subterra-robotics/Subterra-Rover/CAD Models/Chasis Base - Print Parts/03_SecB_negX_outer-face-down.stl

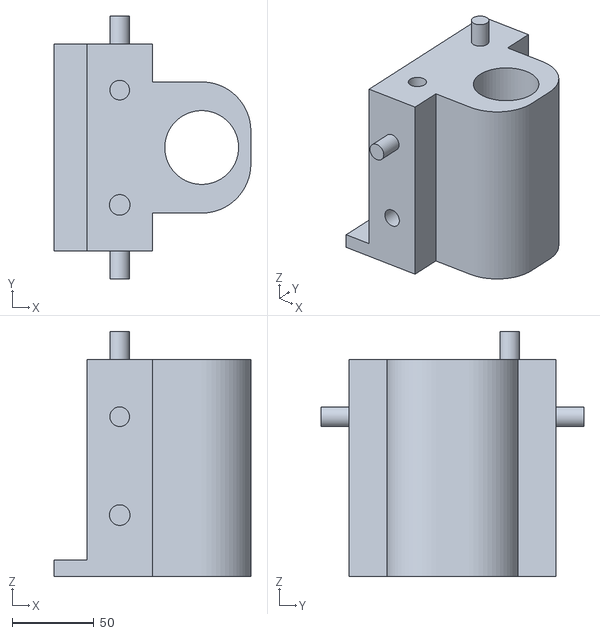
[picture p1: CAD file, 2026-11-07]
CAD Models/Chasis Base - Print Parts/03_SecB_negX_outer-face-down.stl
120.0 x 160.4 x 149.5
