subterra-robotics/Subterra-Rover/CAD Models/Chasis Base - Print Parts/01_SecA_negX_floor-down.stl

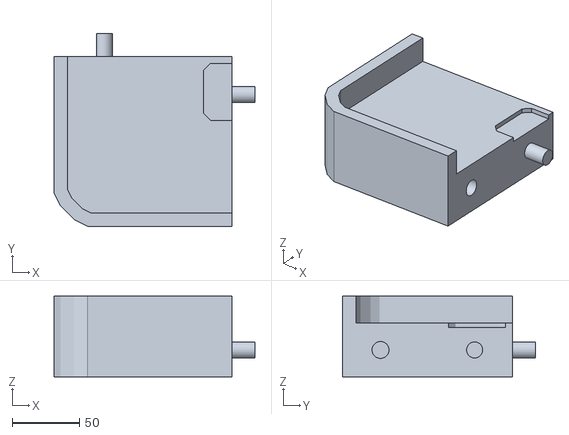
[picture p2: CAD file, 2026-11-07]
CAD Models/Chasis Base - Print Parts/01_SecA_negX_floor-down.stl
149.5 x 143.4 x 60.0
