subterra-robotics/Subterra-Rover/CAD Models/Chasis Base - Print Parts/02_SecA_posX_floor-down.stl

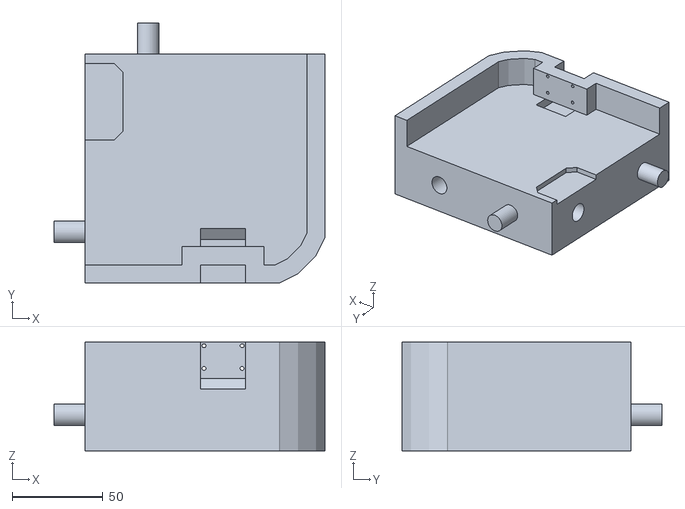
[picture p3: CAD file, 2026-11-07]
CAD Models/Chasis Base - Print Parts/02_SecA_posX_floor-down.stl
149.5 x 143.4 x 60.0
