subterra-robotics/Subterra-Rover/(list of files, cad)

Other CAD files:
CAD Models/Chasis Base - Print Parts/05_SecC_negX_floor-down.stl
CAD Models/Chasis Base - Print Parts/04_SecB_posX_outer-face-down.stl
CAD Models/Chasis Base - Print Parts/06_SecC_posX_floor-down.stl
CAD Models/Eye Casing - 10-5-2026.f3d
CAD Models/Eye Casing.f3d
