subterra-robotics/Subterra-Rover/docs/Testing data.docx

## Wifi Testing

No blockage
1 meter

03:09:12 CONNECTED signal= -- ping= 147 ms loss= 0%

03:09:13 CONNECTED signal= -- ping= 65 ms loss= 0%

03:09:14 CONNECTED signal= -- ping= 3 ms loss= 0%

03:09:15 CONNECTED signal= -- ping= 10 ms loss= 0%

03:09:16 CONNECTED signal= -- ping= 3 ms loss= 0%

03:09:17 CONNECTED signal= -- ping= 2 ms loss= 0%

03:09:18 CONNECTED signal= -- ping= 8 ms loss= 0%

03:09:19 CONNECTED signal= -- ping= 17 ms loss= 0%

03:09:20 CONNECTED signal= -- ping= 29 ms loss= 0%

03:09:21 CONNECTED signal= -- ping= 124 ms loss= 0%

5 meters

03:09:28 CONNECTED signal= -- ping= 2 ms loss= 0%

03:09:29 CONNECTED signal= -- ping= 138 ms loss= 0%

03:09:30 CONNECTED signal= -- ping= 168 ms loss= 0%

03:09:31 CONNECTED signal= -- ping= 20 ms loss= 0%

03:09:32 CONNECTED signal= -- ping= 201 ms loss= 0%

03:09:33 CONNECTED signal= -- ping= 27 ms loss= 0%

03:09:34 CONNECTED signal= -- ping= 2 ms loss= 0%

03:09:35 CONNECTED signal= -- ping= 71 ms loss= 0%

03:09:36 CONNECTED signal= -- ping= 105 ms loss= 0%

03:09:37 CONNECTED signal= -- ping= 5 ms loss= 0%

10 meters

03:09:46 CONNECTED signal= -- ping= 89 ms loss= 10%

03:09:47 CONNECTED signal= -- ping= 118 ms loss= 10%

03:09:48 CONNECTED signal= -- ping= 147 ms loss= 10%

03:09:49 CONNECTED signal= -- ping= 72 ms loss= 10%

03:09:50 CONNECTED signal= -- ping= 96 ms loss= 10%

03:09:51 CONNECTED signal= -- ping= 22 ms loss= 10%

03:09:52 CONNECTED signal= -- ping= 3 ms loss= 10%

03:09:53 CONNECTED signal= -- ping= 167 ms loss= 10%

03:09:54 CONNECTED signal= -- ping= 79 ms loss= 0%

03:09:55 CONNECTED signal= -- ping= 3 ms loss= 0%

20 meters

03:10:06 CONNECTED signal= -- ping= lost loss= 10%

03:10:06 CONNECTED signal= -- ping= 133 ms loss= 10%

03:10:07 CONNECTED signal= -- ping= 110 ms loss= 10%

03:10:08 CONNECTED signal= -- ping= 194 ms loss= 10%

03:10:09 CONNECTED signal= -- ping= 171 ms loss= 10%

03:10:10 CONNECTED signal= -- ping= 233 ms loss= 10%

03:10:11 CONNECTED signal= -- ping= 83 ms loss= 10%

03:10:12 CONNECTED signal= -- ping= 107 ms loss= 10%

03:10:13 CONNECTED signal= -- ping= 164 ms loss= 10%

03:10:14 CONNECTED signal= -- ping= 103 ms loss= 10%

03:10:15 CONNECTED signal= -- ping= 24 ms loss= 0%

Walking further away starting from 20 meters, ending bout 50 meters

03:10:17 CONNECTED signal= -- ping= lost loss= 10%

03:10:17 CONNECTED signal= -- ping= 2 ms loss= 10%

03:10:18 CONNECTED signal= -- ping= 2 ms loss= 10%

03:10:20 CONNECTED signal= -- ping= lost loss= 20%

03:10:20 CONNECTED signal= -- ping= 99 ms loss= 20%

03:10:22 CONNECTED signal= -- ping= lost loss= 30%

03:10:22 CONNECTED signal= -- ping= 170 ms loss= 30%

03:10:24 CONNECTED signal= -- ping= lost loss= 40%

03:10:24 CONNECTED signal= -- ping= 6 ms loss= 40%

03:10:25 CONNECTED signal= -- ping= 13 ms loss= 40%

03:10:26 CONNECTED signal= -- ping= 241 ms loss= 30%

03:10:28 CONNECTED signal= -- ping= lost loss= 40%

03:10:29 CONNECTED signal= -- ping= lost loss= 50%

03:10:30 CONNECTED signal= -- ping= lost loss= 50%

03:10:31 CONNECTED signal= -- ping= 951 ms loss= 50%

03:10:32 CONNECTED signal= -- ping= lost loss= 50%

03:10:33 CONNECTED signal= -- ping= 952 ms loss= 50%

03:10:34 CONNECTED signal= -- ping= lost loss= 50%

03:10:35 CONNECTED signal= -- ping= lost loss= 60%

03:10:36 CONNECTED signal= -- ping= lost loss= 70%

03:10:36 CONNECTED signal= -- ping= 144 ms loss= 70%
