subterra-robotics/Subterra-Rover/Schematic V1.pdf

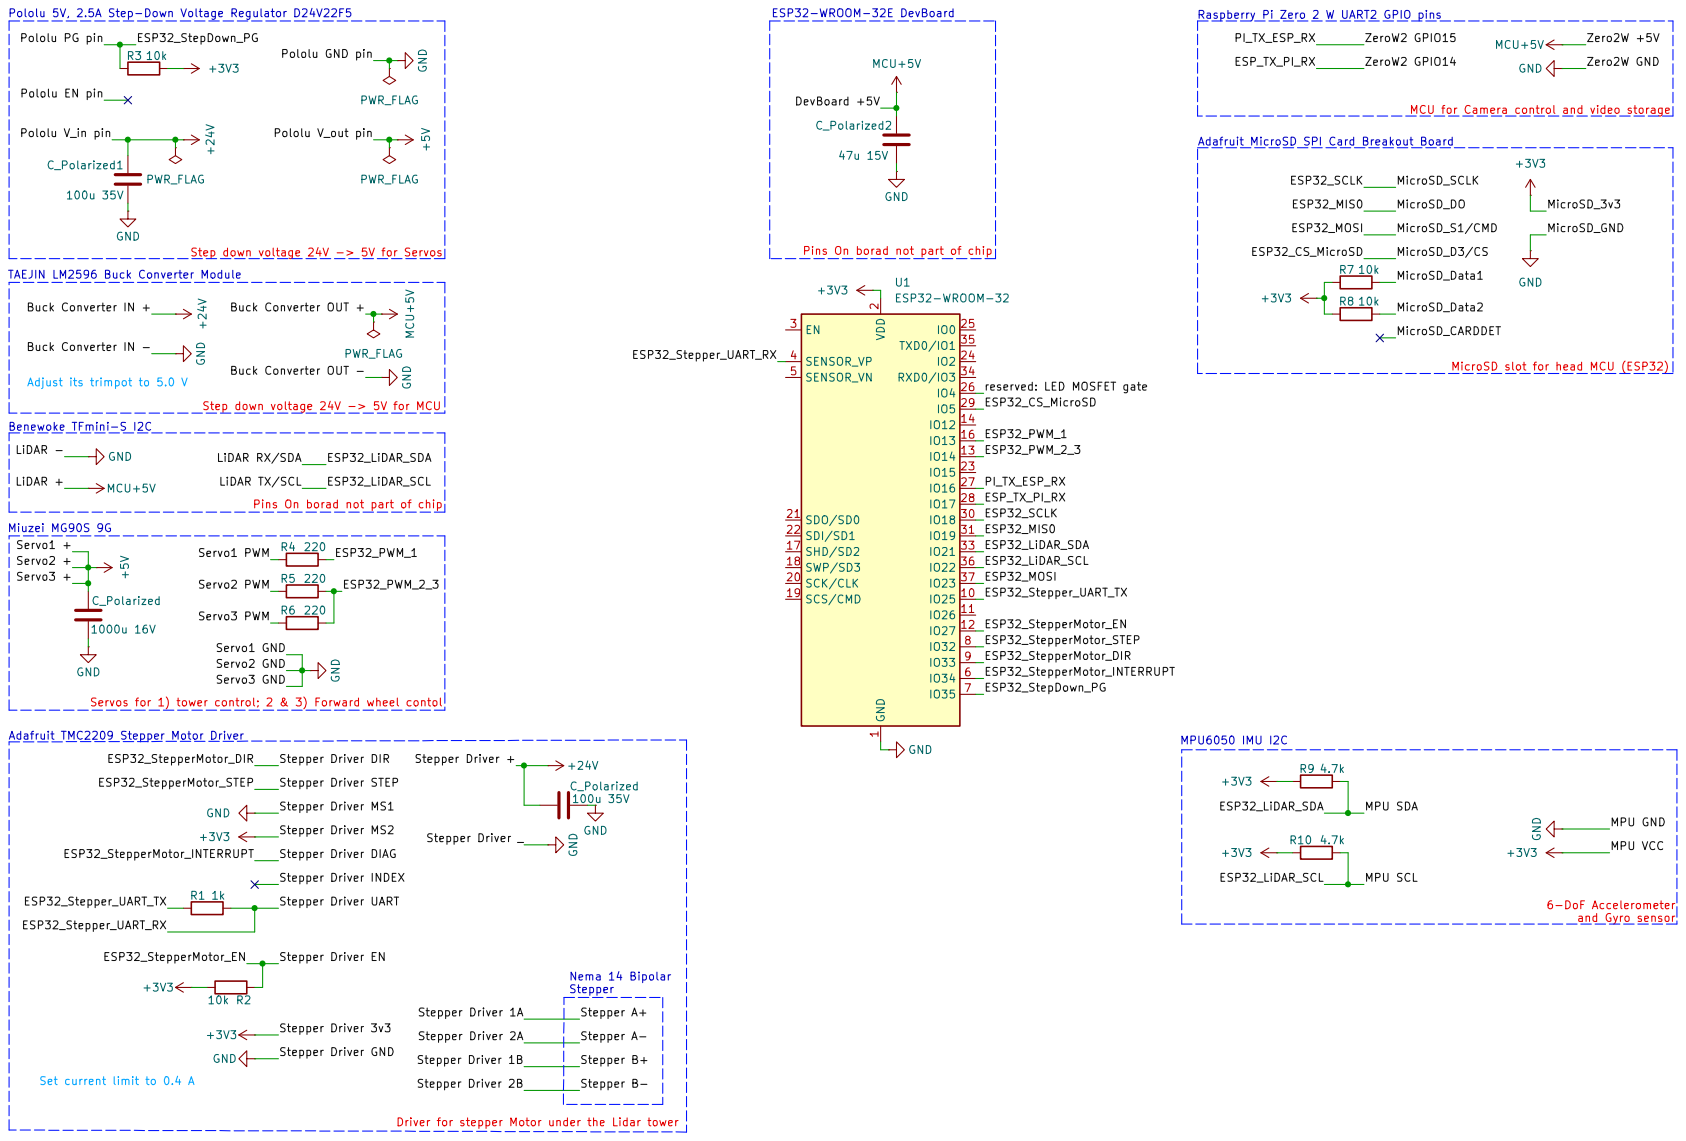
[picture p4: page 1]
