subterra-robotics/Subterra-Rover/hardware/SubterraRover_Schematics/SubterraRover_Schematics.kicad_pcb

## KiCad design DemoGit.kicad_sch

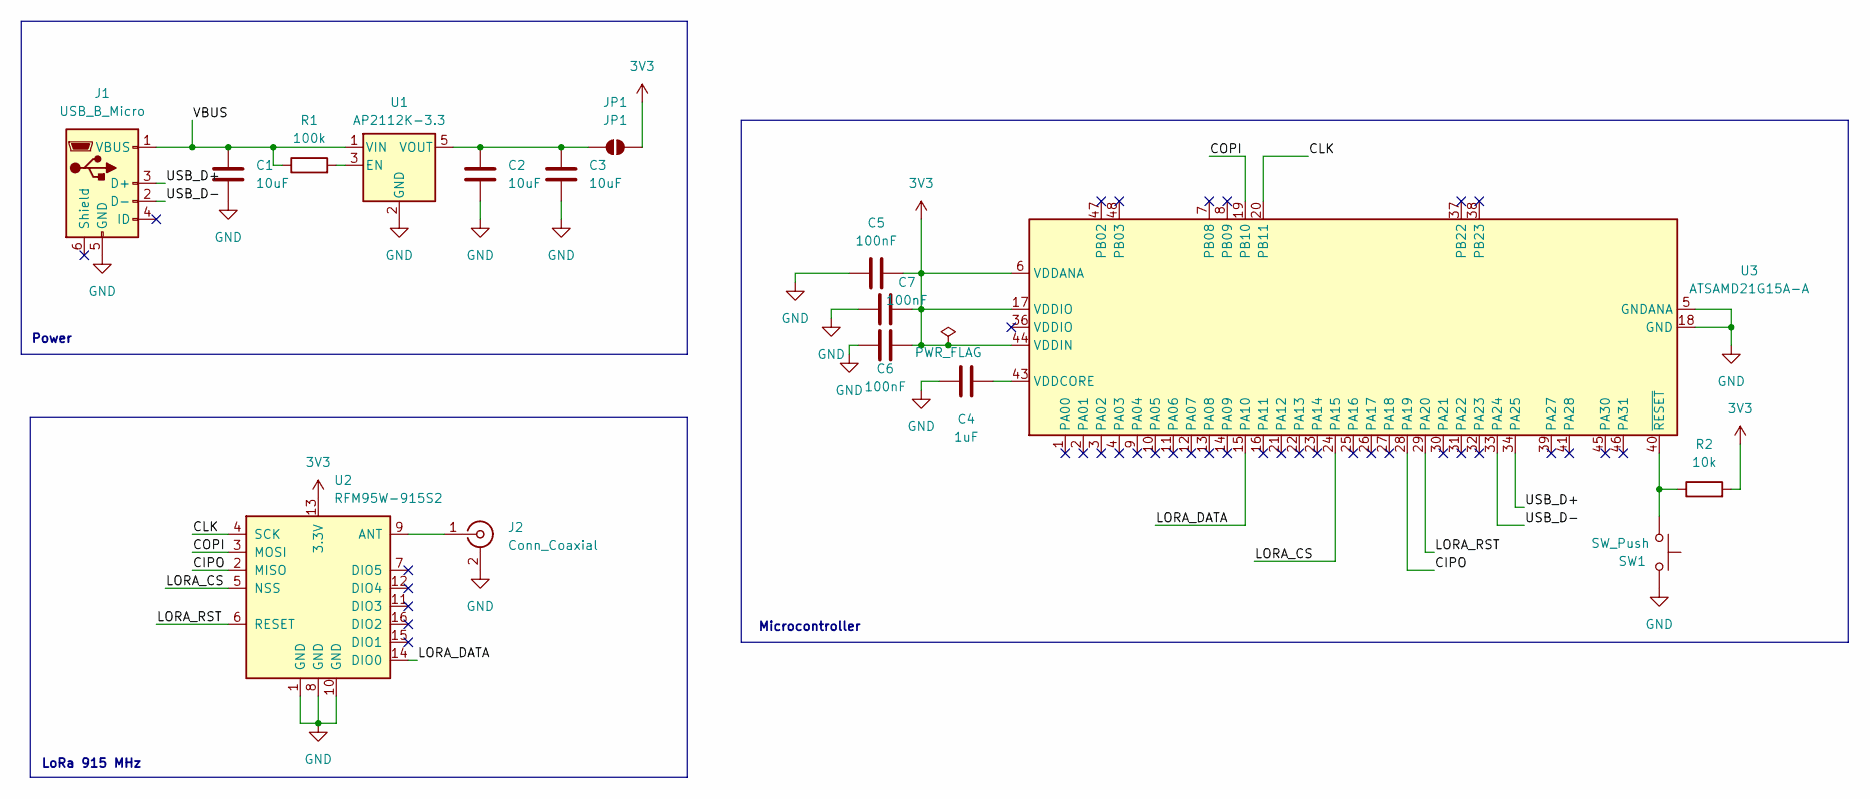
[picture p5: schematic DemoGit.kicad_sch]

Parts:
C1, C2, C3: 10uF
C4: 1uF
C5, C6, C7: 100nF
J1: USB_B_Micro
J2: Conn_Coaxial
JP1: JP1
R1: 100k
R2: 10k
SW1: SW_Push
U1: AP2112K-3.3; SOT-23-5
U2: RFM95W-915S2
U3: ATSAMD21G15A-A; TQFP-48_7x7mm_P0.5mm

Connections:
3V3: C5.1, C6.1, C7.1, JP1.2 (B), R2.2, U2.13 (3.3V), U3.6 (VDDANA), U3.17 (VDDIO), U3.44 (VDDIN)
CIPO: U2.2 (MISO), U3.28 (PA19)
CLK: U2.4 (SCK), U3.20 (PB11)
COPI: U2.3 (MOSI), U3.19 (PB10)
GND: C1.2, C2.2, C3.2, C4.2, C5.2, C6.2, C7.2, J1.5 (GND), J2.2 (Ext), SW1.2, U1.2 (GND), U2.1 (GND), U2.8 (GND), U2.10 (GND), U3.5 (GNDANA), U3.18 (GND), U3.35 (GND), U3.42 (GND)
LORA_CS: U2.5 (NSS), U3.24 (PA15)
LORA_DATA: U2.14 (DIO0), U3.15 (PA10)
LORA_RST: U2.6 (RESET), U3.29 (PA20)
unnamed: C2.1, C3.1, JP1.1 (A), U1.5 (VOUT)
unnamed: C4.1, U3.43 (VDDCORE)
unnamed: J2.1 (In), U2.9 (ANT)
unnamed: R1.2, U1.3 (EN)
unnamed: R2.1, SW1.1, U3.40 (~RESET)
USB_D+: J1.3 (D+), U3.34 (PA25)
USB_D-: J1.2 (D-), U3.33 (PA24)
VBUS: C1.1, J1.1 (VBUS), R1.1, U1.1 (VIN)

Notes on the sheet:
LoRa 915 MHz
Microcontroller
Power
