subterra-robotics/Subterra-Rover/(commit log)

2026-09-19 CAD models
2026-09-20 Add files via upload
    V2
    [Eye Casing.f3d]
2026-10-05 Add files via upload
    Whats left here is edits for fits, screw threads, deciding what needs to be fixed, which parts are combined, etc. and tolerances/fit checks
    [Eye Casing - 10-5-2026.f3d]
2026-11-07 Presentation Day
    Update of project for Challange +X presentation, Project will continue afterwards
    [SubterraRover_Schematics.kicad_pcb, SubterraRover_Schematics.kicad_sch]
